SE-O22-ITESO/p3-pipeline-david_michel-ethan_castillo/asm/fwd_unit_test.txt

0fc10697
02468693
00100f13
0106ae83
fe0e8ee3
01e6aa23
0006aa23
00300913
00590a93
012a84b3
41548a33
0144fb33
009a6c33
018b4a33
009c0993
002a0913
004c0a13
012a8ab3
014aaab3
015a69b3
015a8ab3
013a9bb3
