SE-O22-ITESO/p3-pipeline-david_michel-ethan_castillo/docs/DM_Michel_Castillo_RISC_V_PIPELINE.pdf

Departamento de Electrónica, Sistemas e Informática

Diseño de Microprocesadores Práctica 3: Pipeline

David Adrián Michel Torres Eduardo Ethandrake Castillo Pulido

Realizar la implementación del procesador RISC-V pipeline visto en clase. Este procesador debe ser capaz de ejecutar un programa que calcule la multiplicación de una matriz por vector. La matriz y el vector se trasmitirá a través de una terminal serial, se recomienda el uso de docklight, pero puede cualquier otra terminal que sea capaz de transmitir valores hexadecimales directamente. La matriz tendrá una dimisión fija de 4x4 y el vector de 4x1.

Actividad a realizar

En particular en esta práctica se tiene que realizar la siguientes modificaciones o extensiones al procesador Single-Cycle:

- Segmentar el procesador Single-Cycle con los registros necesarios para poder crear un procesador pipeline con 5 etapas.
- Implementar la unidad de forwarding para eliminar o reducir el número de burbujas que se necesitan insertar cuando se presenta un hazard de datos en instrucciones de tipo aritmético-lógico.
- Implementar la unidad de data hazards para reducir el número de burbujas que se necesitan insertar para la instrucción (lw).
- Implementar predicción de saltos estática asumiendo Branch not taken para los saltos condicionales (beq y bne). La decisión de tomar el brinco o realizar el flush de registros se realizará en la etapa 4 (MEM).
- La información de la matriz y vector se pueden recibir mediante polling.

Extra:

Predicción de brincos con un bit de predicción

- Predicción de brincos con BTB y un BTH con un bit de predicción

Entregables

Un reporte en canvas que contenga:

1. Captura de pantalla donde se explique y demuestre el funcionamiento de:
a. Forwarding Unit

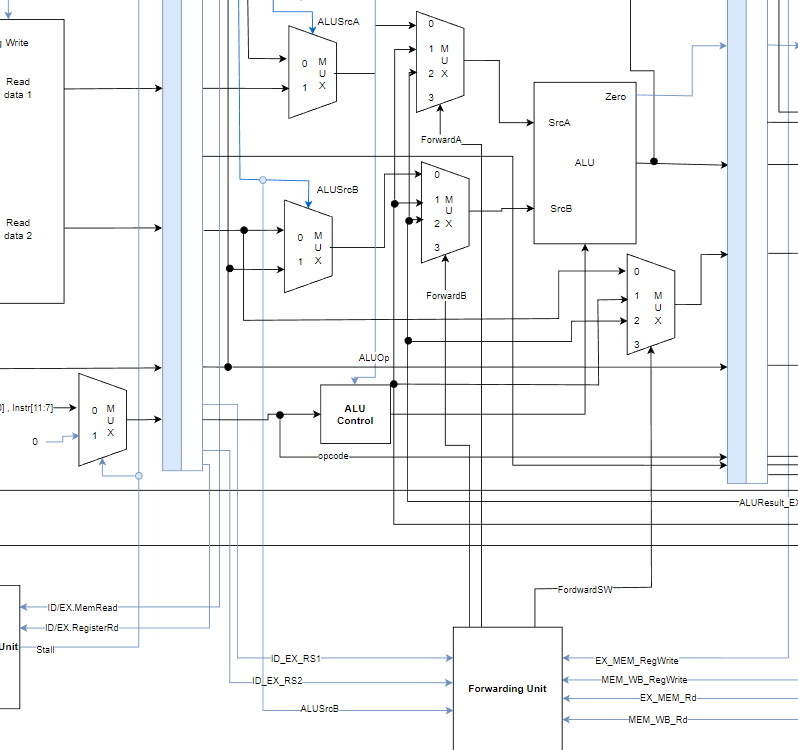
[picture p1: figure]

Imagen 1 – Diagrama de conexión de la forward unit

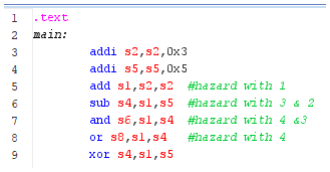
[picture p2: figure]

Imagen 2 – Programa usado para probar dependencias de Hazard de datos

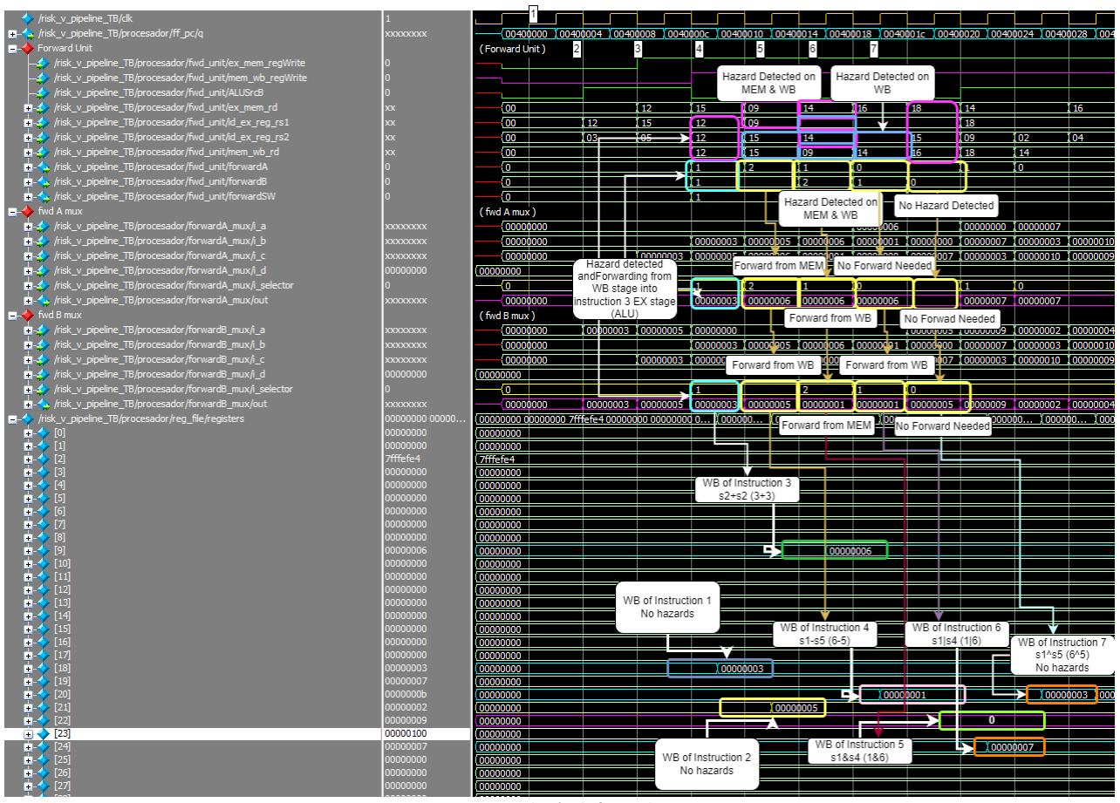
[picture p3: figure]

Imagen 3 - Simulación de forward unit

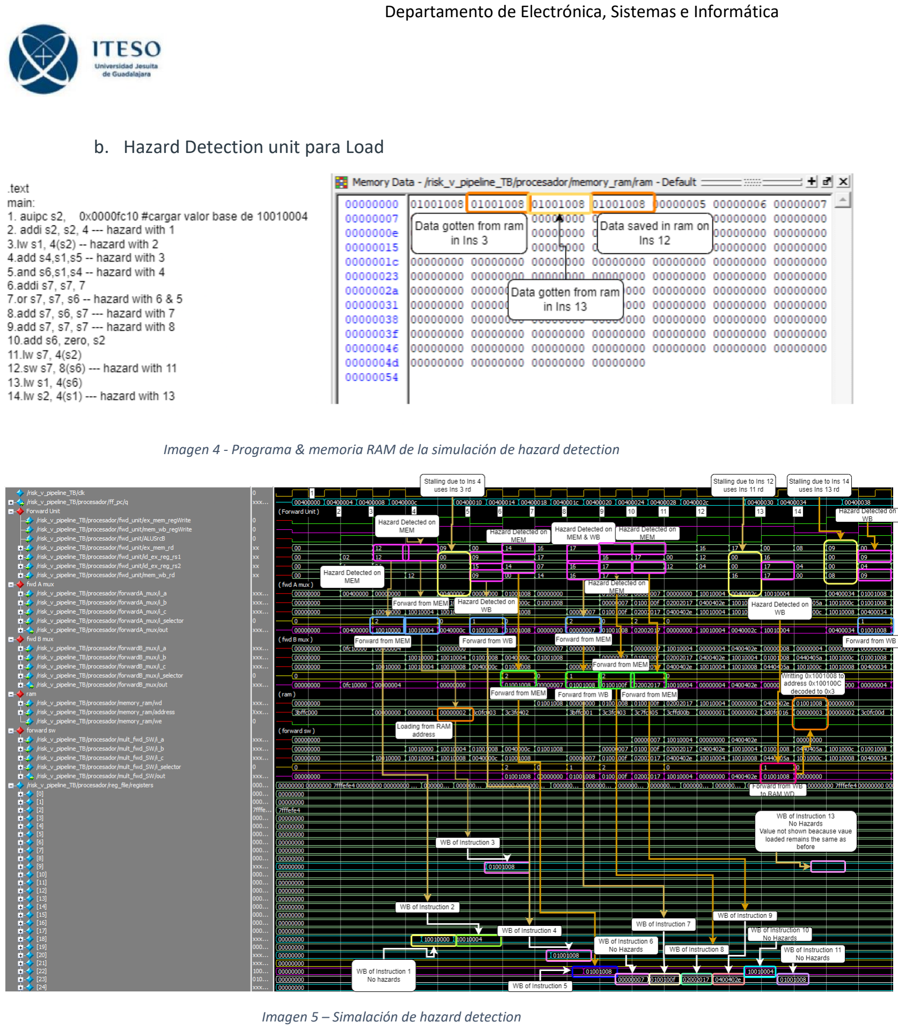
[picture p4: page 4]

b. Hazard Detection unit para Load

Imagen 4 - Programa & memoria RAM de la simulación de hazard detection

Imagen 5 – Simalación de hazard detection c. Hazard Detection unit para beq y bne (El flush de registros en caso de una mala predicción)

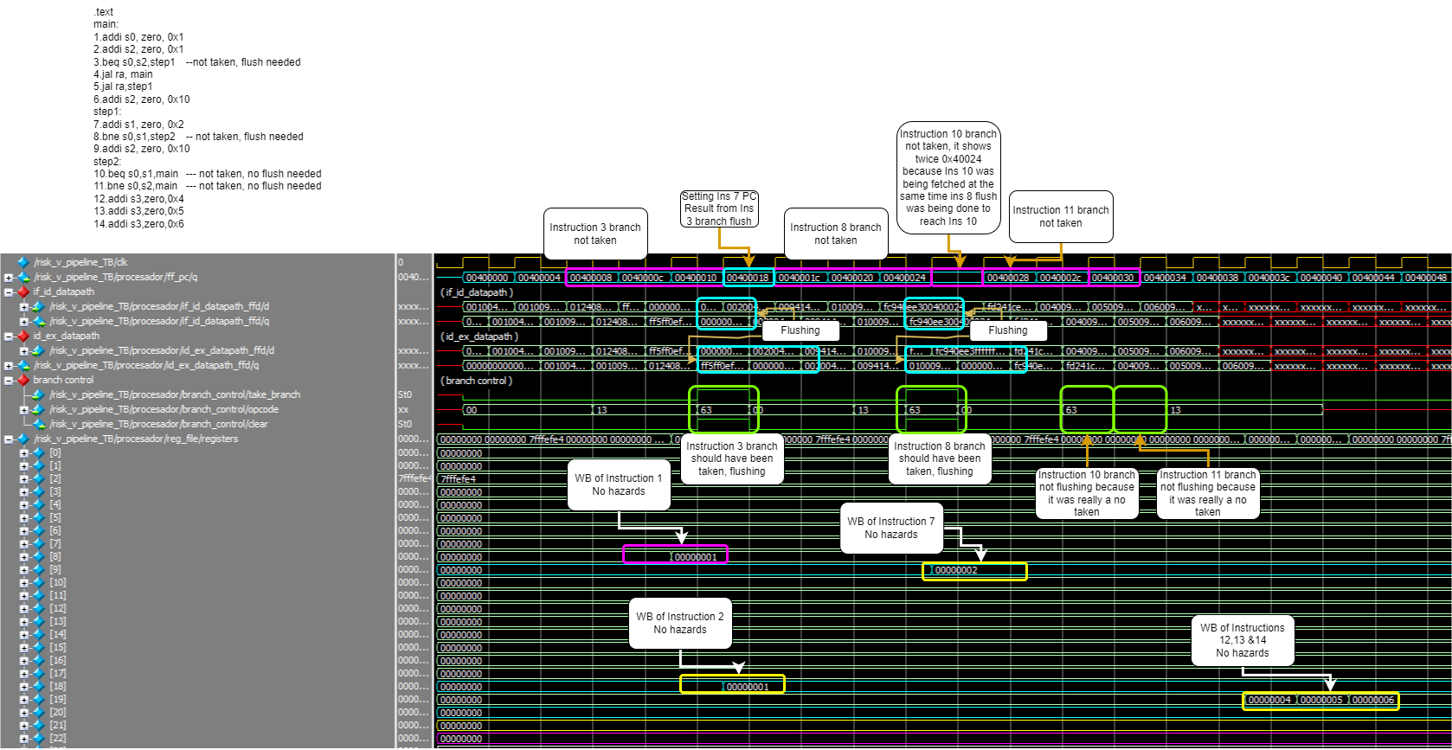
[picture p5: figure]

Imagen 6 – Simulación de flush de registros en caso de una mala predicción beq y bne d. En el caso de implementar el la predicción de brincos añadir captura de pantalla de la simulación.

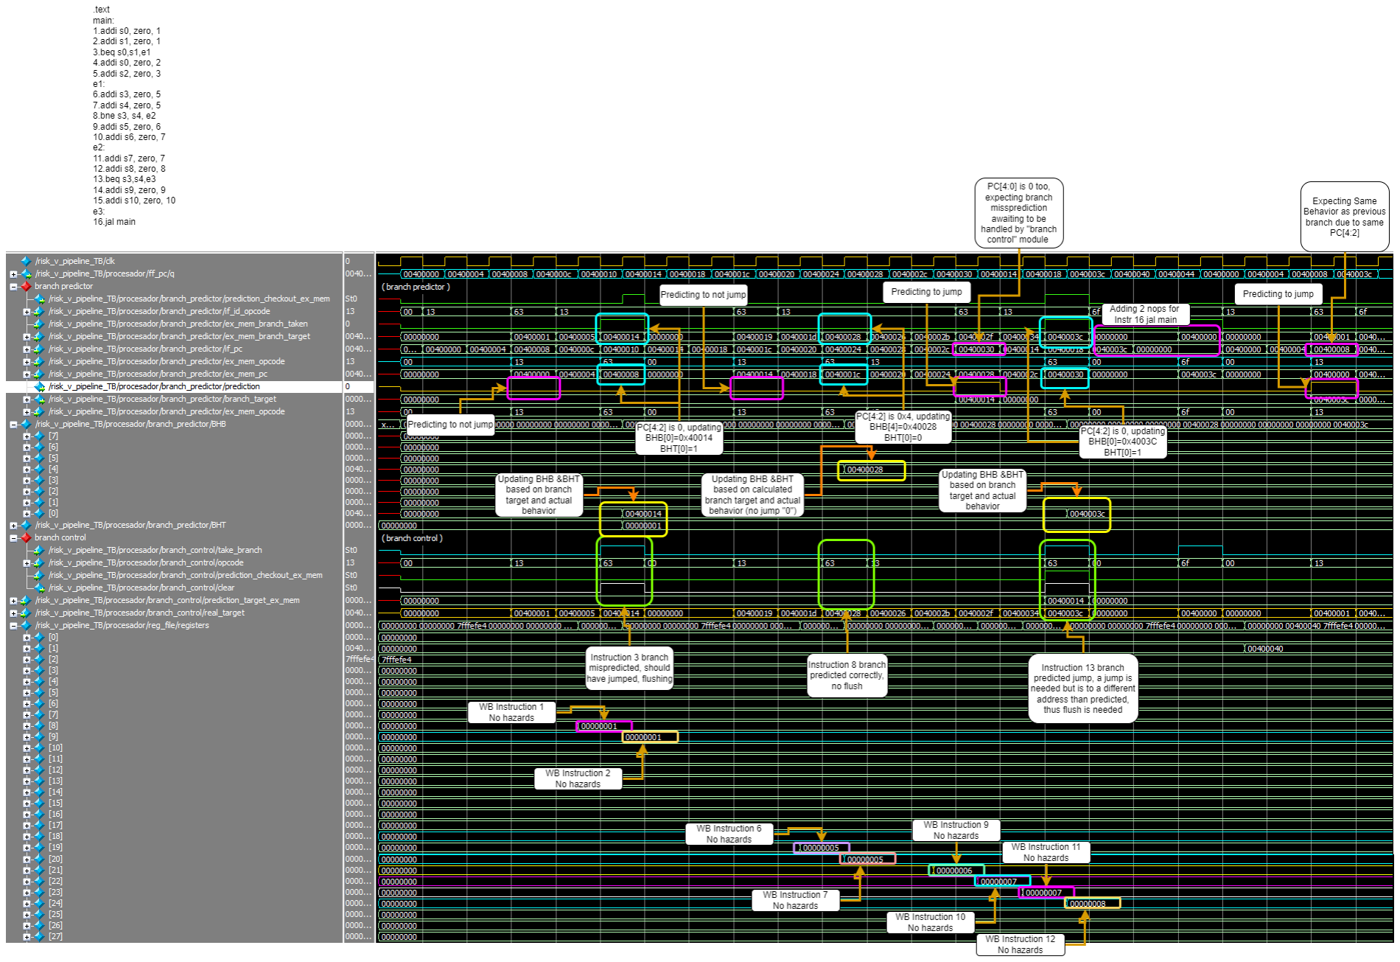
[picture p6: figure]

Imagen 7 – Simulación del branch predictor

e. En los puntos anteriores es necesario usar el formato de presentación de simulación.

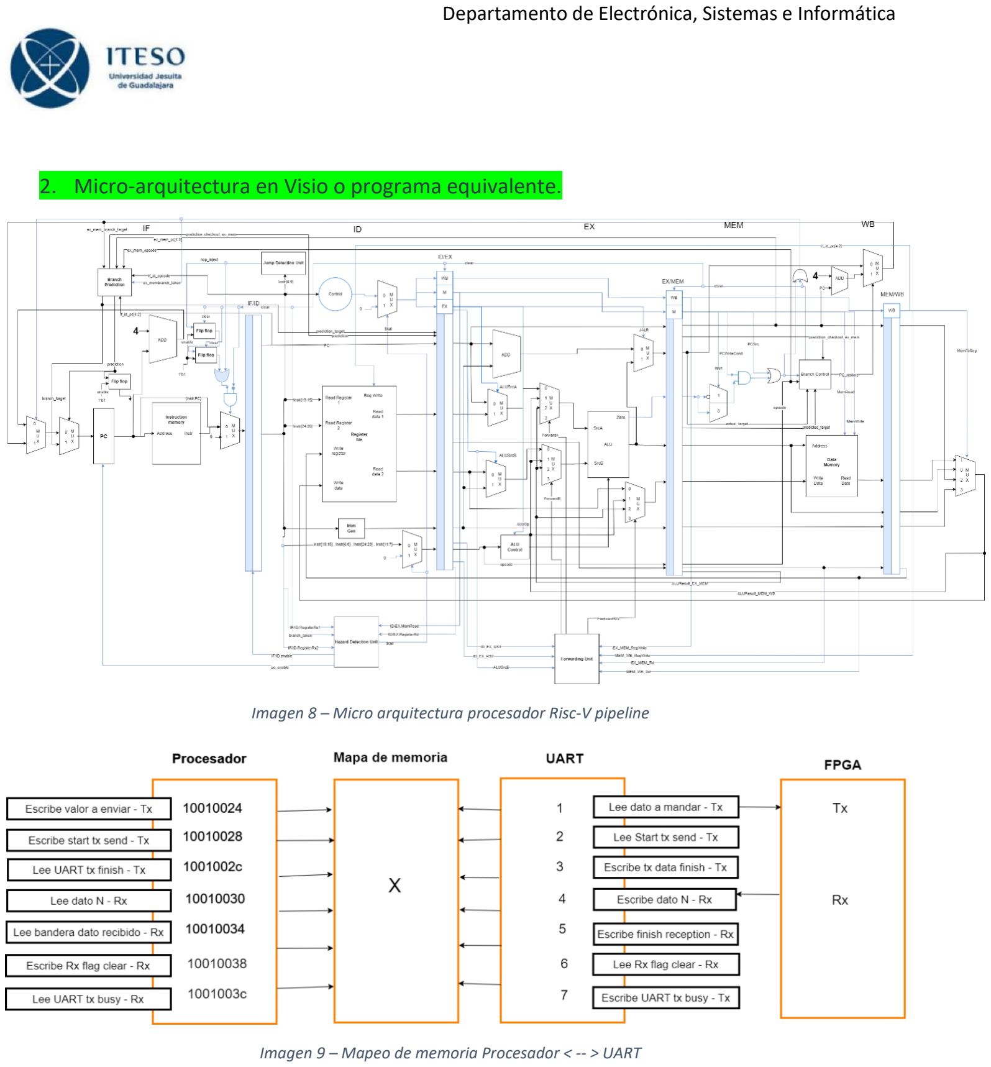
[picture p7: page 7]

2. Micro-arquitectura en Visio o programa equivalente.

Imagen 8 – Micro arquitectura procesador Risc-V pipeline

Imagen 9 – Mapeo de memoria Procesador < -- > UART

3. Captura de pantalla de las señales internas usando el Signal Tap que demuestren el funcionamiento del Forwarding Unit y Hazard Detection.
- Forwarding unit

Para demostrar el funcionamiento del forward unit, se utilizo el siguiente programa donde se buscó estresar dependencias de datos que requirieran adelantar el dato a la ejecución y tener datos correctos.

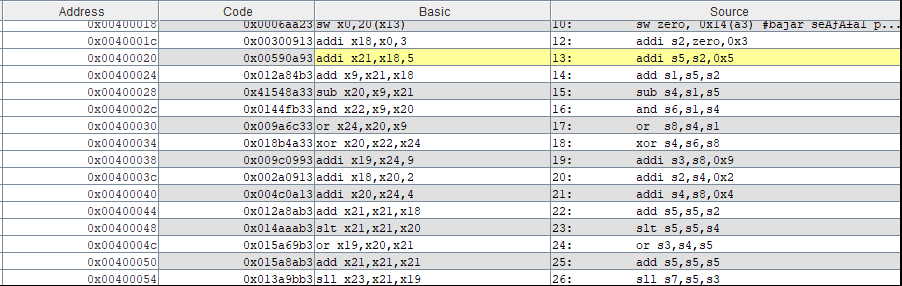
[picture p8: figure]

Imagen 10 – Programa usado para demostración de forward unit usando signal tap

Una vez ejecutado el programa, se capturaron las señales de signal tap para realizar el análisis del forward unit.

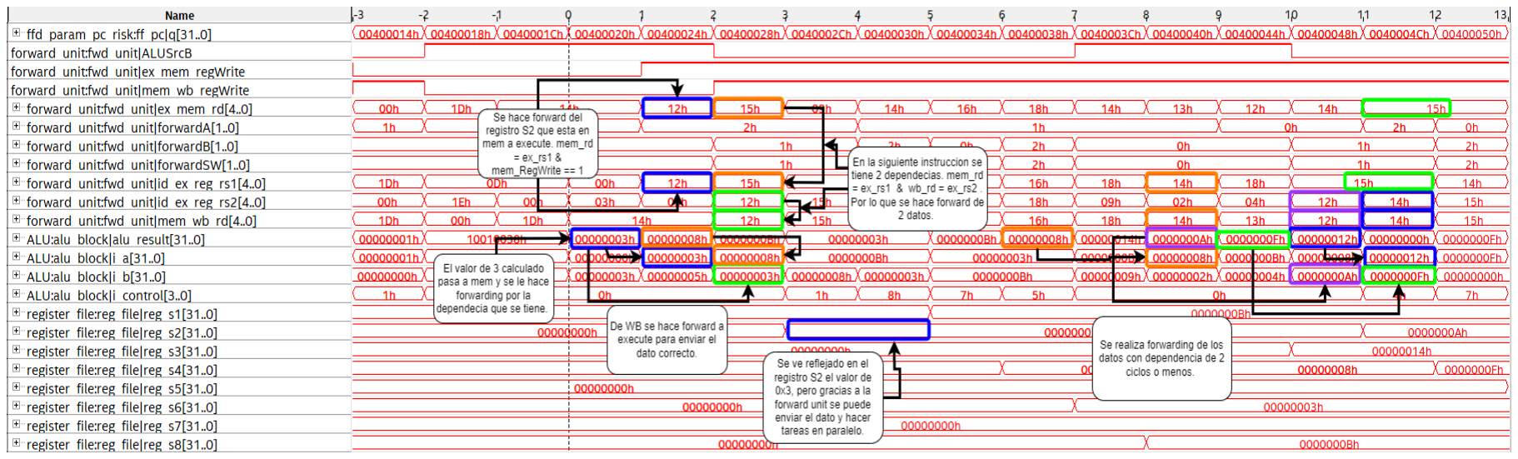
[picture p9: figure]

Imagen 11 – Demostración del funcionamiento de forward unit con signal tap

Se puede observar que cuando se tienen dependencias de datos, el forward unit tiene condiciones en las cuales determina cuando se debe hacer forwarding del dato. Que a resumidas cuentas es cuando es RD es igual al RS1 o RS2, dependiendo si está el dato en MEM o WB y se tengan los regWrite en valor de 0x1.

En la imagen se puede observar como se hace forwarding de los datos calculados de la ALU, que en realidad pasan al registro de MEM, y luego al registro de WB. Ahí dependiendo de le dependencia es si ese resultado se forwardea desde MEM o WB hasta la parte de ejecución como se muestra en la imagen.

- Hazard detection

Se utilizo el siguiente programa para poder validar diferentes condiciones en el Hazard detection unit.

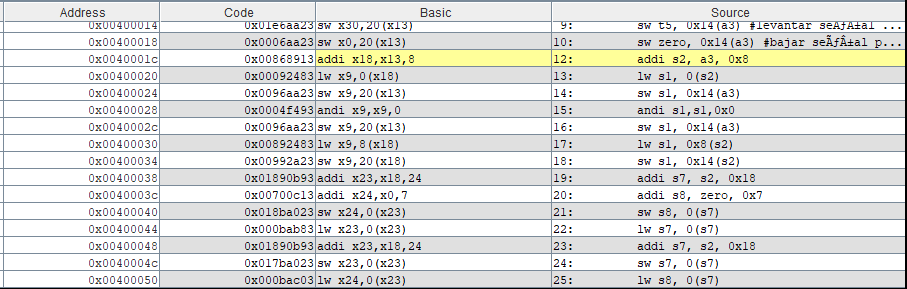
[picture p10: figure]

Imagen 12 – Programa usado para demsotración de Hazard unit usando signal tap

Al correr el programa en el signal tap, se encontraron los siguientes resultados:

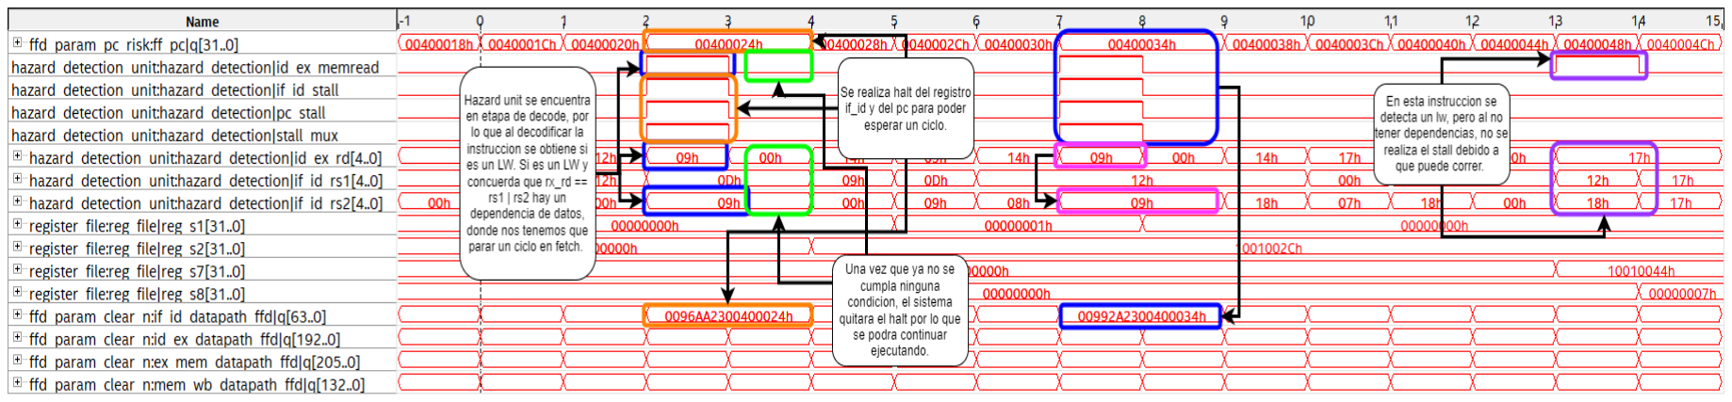
[picture p11: figure]

Imagen 13 – Demostración del funcionamiento de Hazard unit usando signal tap

Debido a que el hazard unit se encuentra en la etapa de decode, se puede saber si la instrucción va a ser un LW, y en dado caso que, sea una instrucción LW se valida si tiene dependencias o no. Como puede ver en la imagen los 2 primeros casos, se tenia una dependencia de ex_rd y id_rs2, el cual al ver dependencia se procede a hacer halt del FF del PC y del registro IF_ID para poder parar el sistema un ciclo, y permitir que el pipe por delante avance. En cuanto no se tenga dependencia el sistema removerá el halt para poder ejecutar la instrucción.

En el tercer caso, se detecto que hay un LW, pero como no tiene dependencias puede proceder sin hacer ningún halt que nos permita pararnos un ciclo. Por lo que se valida que funcione el Hazard detection unit para los LW.

4. Una tabla comparativa entre las tres organizaciones implementadas, ejecutando el factorial donde se muestre:
a. Recursos consumidos por el FPGA
b. Frecuencia de operación
c. CPI (Promedio de la organización)
d. CPU time
| MultiCycle | SingleCycle | Pipeline
Recursos consumidos FPGA | Logic utilization (in ALMs) 2,616 / 41,910 ( 6 % ) Total registers 4064 Total pins 4 / 499 ( < 1 % ) Total virtual pins 0 Total DSP Blocks 2 / 112 ( 2 % ) | Logic utilization (in ALMs) 2,201 / 41,910 ( 5 % ) Total registers 2950 Total pins 4 / 499 ( < 1 % ) Total virtual pins 0 Total DSP Blocks 2 / 112 ( 2 % ) | Logic utilization (in ALMs) 3,125 / 41,910 ( 7 % ) Total registers 4834 Total pins 4 / 499 ( < 1 % ) Total virtual pins 0 Total DSP Blocks 2 / 112 ( 2 % )
Frecuencia de operacion | Slow 110mv 85C Fmax = 61.77 Mhz Slow 110mv 0C Fmax = 61.67 Mhz | Slow 110mv 85C Fmax = 41.87 Mhz Slow 110mv 0C Fmax = 42.37 Mhz | Slow 110mv 85C Fmax = 57.79Mhz Slow 110mv 0C Fmax = 59.63Mhz
CPI | 3.8 | 1 | 1
CPU time | 128ns | 34ns | 64ns
Tabla 1 – Comparación de recursos, frecuencia de operación, CPI, CPU time entre 3 diferentes implementaciones

5. Resultados

Una vez que se carga el programa en la FPGA, se procede a presionar el Reset para inicializar todo. Una vez inicializado el sistema, el programa realiza multiplicaciones matriz de dimensión 4x4 y vector de dimensión 4x1. El programa primero esta esperando los 16 elementos de la matriz, y después estará esperando los 4 elementos del vector para poder procesarlos y mostrar el resultado por medio de la UART.

En la imagen se puede ver una demostración de los resultados.

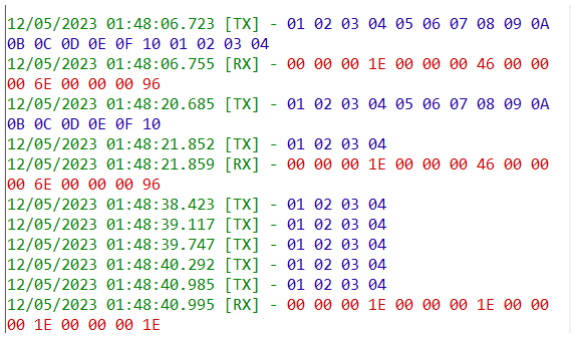
[picture p12: figure]

Imagen 14 – Validación de resultados en UART – P1

En la cual se metieron los 20 datos directos, también se hizo la variante de meter 16 datos de la matriz y luego 4 datos del vector. Y también se metió la variante de enviar datos en paquetes de 4 datos 5 veces para poder llenar los 20 datos. Podemos ver en la imagen que se obtiene el resultado de la matriz como se espera.

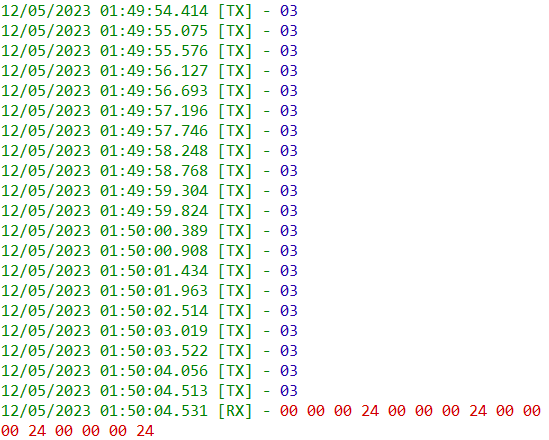
[picture p13: figure]

Imagen 15 – Validación de resultados de UART – P2

También se puede proceder manualmente a meter los 20 datos y también se obtiene los resultados de manera esperada. Por lo que se puede concluir que funcionalmente la practica funciona como se tenia esperado.

6. Historia de desarrollo en git hub usando git classroom:
a. https://github.com/SE-O22-ITESO/p3-pipeline-david_michel-ethan_castillo

Restricciones:

Se tiene que seguir la estructura de la tarea del GPIO

Las direcciones memoria mostradas en la implementación/simulación tiene que coincidir con las mostradas en el RARS, es decir, el program counter comienza en la dirección 0x4000000 y la RAM en la dirección 0x10010000.

La frecuencia de transmisión recepción debe ser 9600 baudios

La implementación del procesador deber ser a través de un diseño estructural, no se admitirán modelos comportamentales. Pero módulos constitutivos del procesador si puede implementarse de manera comportamental, ejemplo, la ALU.

TX UART ---> GPIO[7]-->PIN_AH3

RX UART ---> GPIO[9]--->PIN_AH5

Reset ----> SW9 ----> PIN_AA30
