SE-O22-ITESO/p3-pipeline-david_michel-ethan_castillo/(list of files, cad)

Other CAD files:
signal_tap/hazard_unit.stp
signal_tap/fwd_unit.stp
