SE-O22-ITESO/p3-pipeline-david_michel-ethan_castillo/asm/hazard_test.txt

0fc10697
02468693
00100f13
0106ae83
fe0e8ee3
01e6aa23
0006aa23
00868913
00092483
0096aa23
0004f493
0096aa23
00892483
00992a23
01890b93
00700c13
018ba023
000bab83
01890b93
017ba023
000bac03
